olafbb83/DOOM-console/rpi2350zero.png

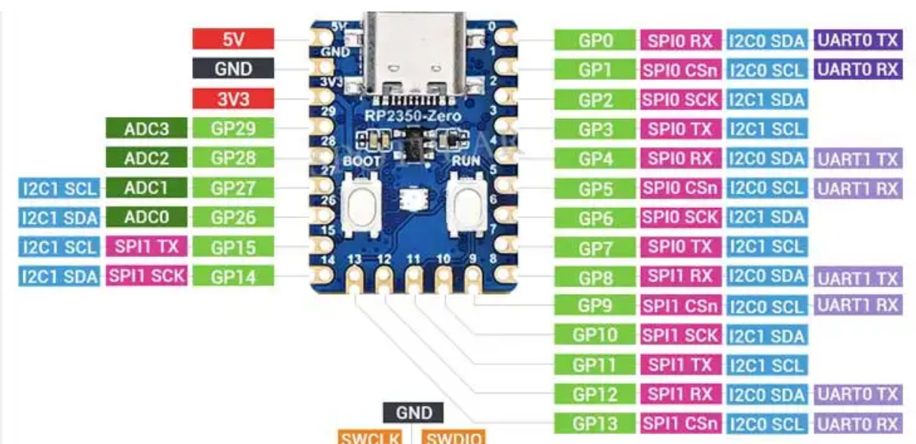
rpi2350zero.png
